loggerhead-instruments/iTag/spec_sheets/sensor_power_budget.xlsx

 | Manufacturer | Qty 1 price | Mode | mA | Notes
Accelerometer/Magnetometer/Gryoscope
LSM9DS1 | ST | $6.40 | 14.9 Hz | 1.9 | 64 byte FIFO gyroscope; 64 byte FIFO accelerometer
LSM9DS1 | ST |  | 59.5 Hz | 2.4 | no FIFO for magnetometer
LSM9DS1 | ST |  | 119 Hz | 3.1
LSM9DS1 | ST |  | 238-952 Hz (normal) | 4.3
LSM9DS1 |  |  | Accel + Mag (normal) | 0.6
MPU9250 | Invensense | $12.70 | 9-axis, 1 kHz gyro, 4 kHz accel, 8 Hz mag | 3.7 | 512 byte FIFO
MPU9250 |  |  | accelerometer 4 kHz, Mag 8 Hz | 0.73 | Can calculate and output quaternions
MPU9250 |  |  | accelerometer 31 Hz | 0.0198 | Can sample from up to 4 (24 bytes) I2C sensors into FIFO
MPU9250 |  |  | magnetometer 8 Hz | 0.28 | User programmable filters for sensors
 |  |  |  |  | Can read magnetometer directly for faster mag sample rate
Light Sensors
ISL29125 | Intersil | $3.19 | RGB | 0.056
Pressure Temperature
MS5803-30BA | Measurement Specialties | $27.91 |  | 0.001 | max of 300 m
Series 4Ld…9LD | Keller (http://www.kelleramerica.com/categories/oem-sensors-transducers-transmitters.html) | $175 |  |  | 1 cm diameter max of 2000 m
Series 1 TAB | Keller (http://www.kelleramerica.com/categories/oem-sensors-transducers-transmitters.html) |  |  |  | need to add conditioning electronics and way for sensor to be exposed to ambient pressure
Series 7 | Keller (http://www.kelleramerica.com/categories/oem-sensors-transducers-transmitters.html) |  |  |  | need to add conditioning electronics ; selaed; 200 bar max; 15 mm
Series 7 Ly | Keller (http://www.kelleramerica.com/categories/oem-sensors-transducers-transmitters.html) |  |  |  | Voltage output; packaged with conditioning circuitry
