loggerhead-instruments/iTag/manual/setting up Arduino to use with iTag.pptx

Setting up Arduino IDE to use with iTag for testing sensors

1. Install Arduino
2. Tools Menu: Board.
  1. Select Arduino/Genuino Zero (Native USB Port)
  2. If that is not a choice, go to top of list and open Boards Manager, and install Arduino SAMD Boards (32-bits ARM Cortex-M0+) by Arduino
3. iTag Board
  1. Plug in battery
  2. Plug in USB
  3. It should connect to USB
  4. From Arduino Tools menu, select Port and see if you see a COM port with the Arduino/Genuino Zero, and select it
4. Serial Monitor
  1. Open Serial monitor from Arduino Tools menu
  2. Type a 9 in the box at the top and press Enter to start the test sequence. Once the test sequence is over, you can remove the microSD card to open the CSV file. You can run multiple tests in a row by pressing 9. They will be appended to the same CSV.

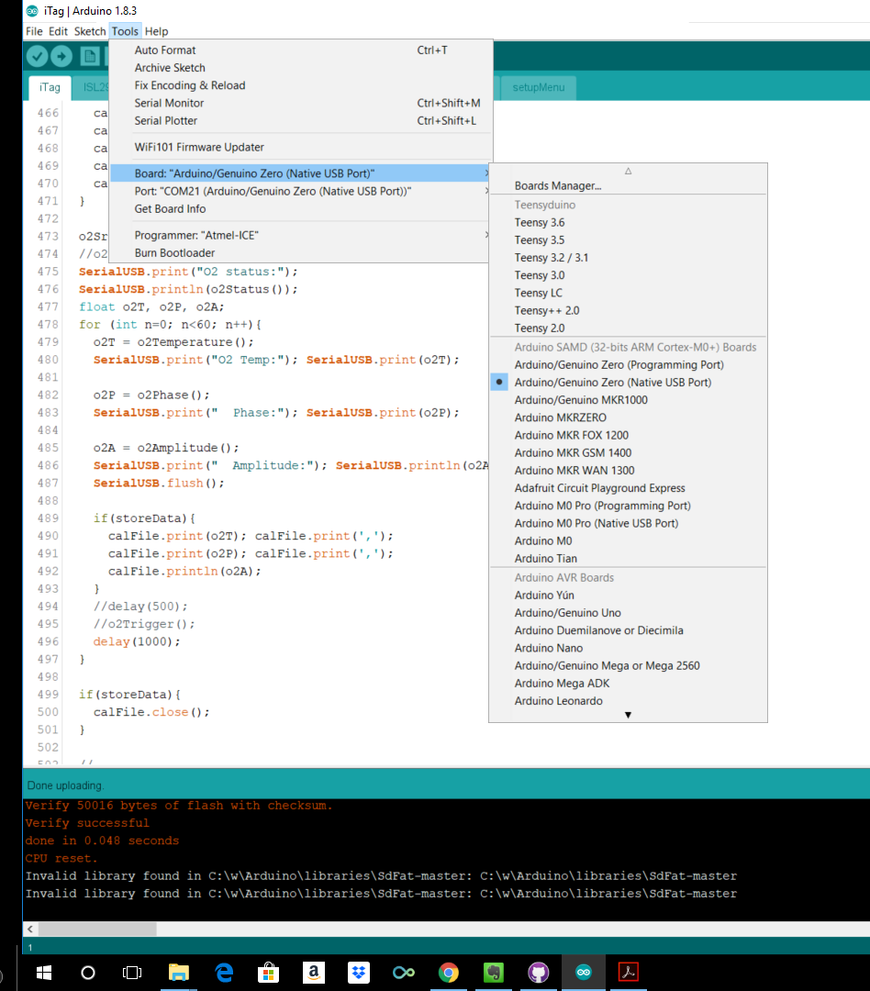
[picture p1: figure]
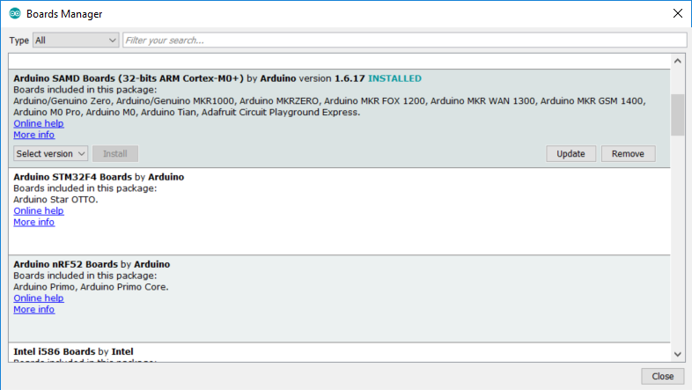
[picture p2: figure]

## Slide 2

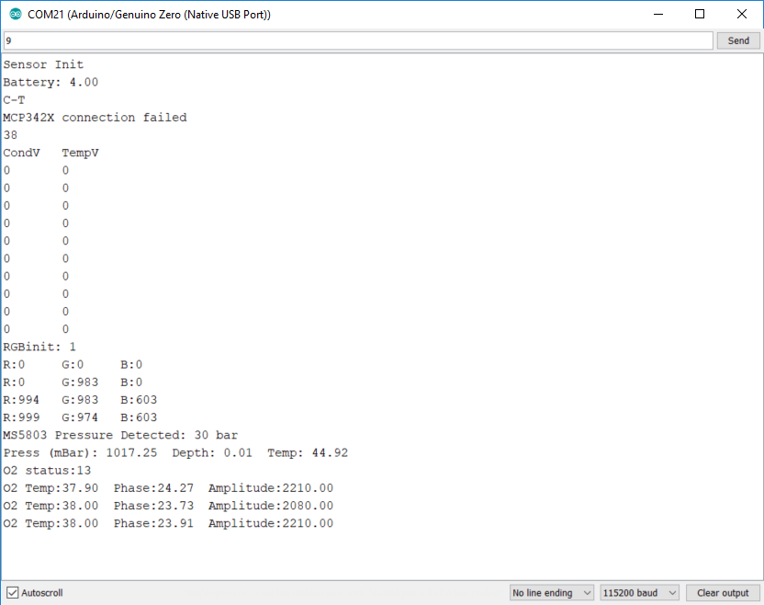
[picture p3: figure]
