loggerhead-instruments/iTag/manual/iTagLayout.png

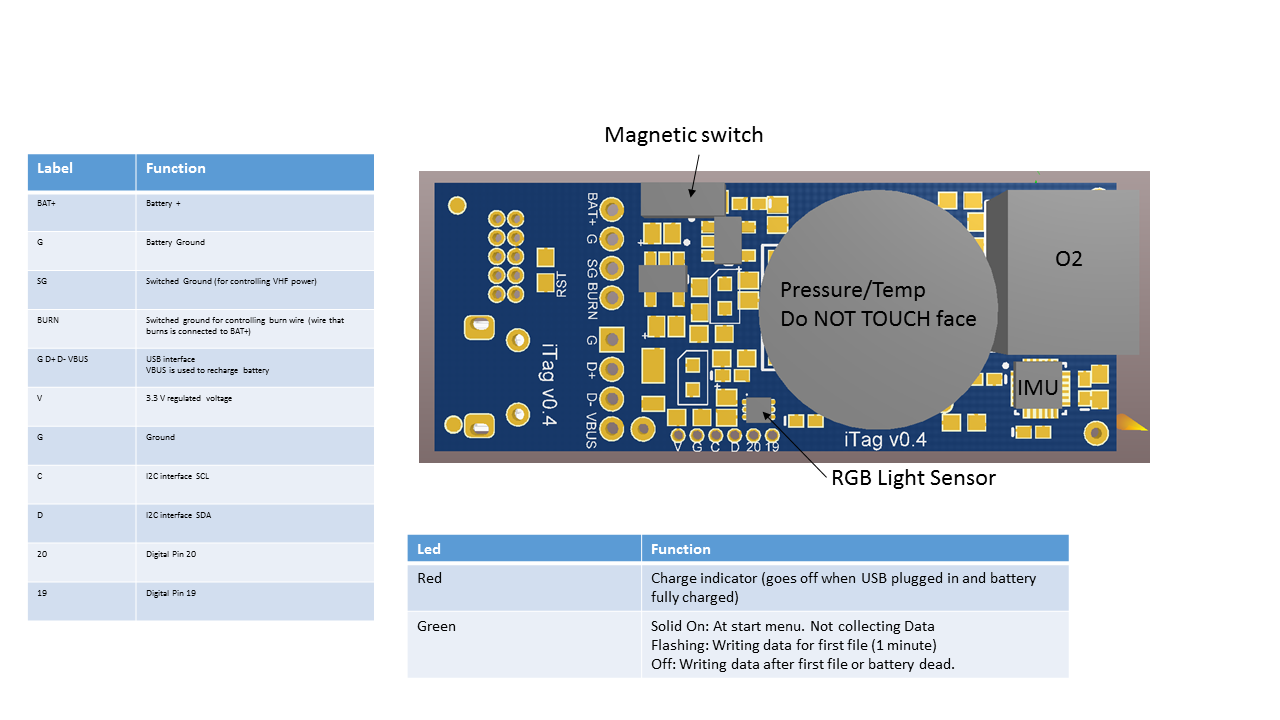
manual/iTagLayout.png
