loggerhead-instruments/iTag/Arduino/salinityTest/salinity_temp.PNG

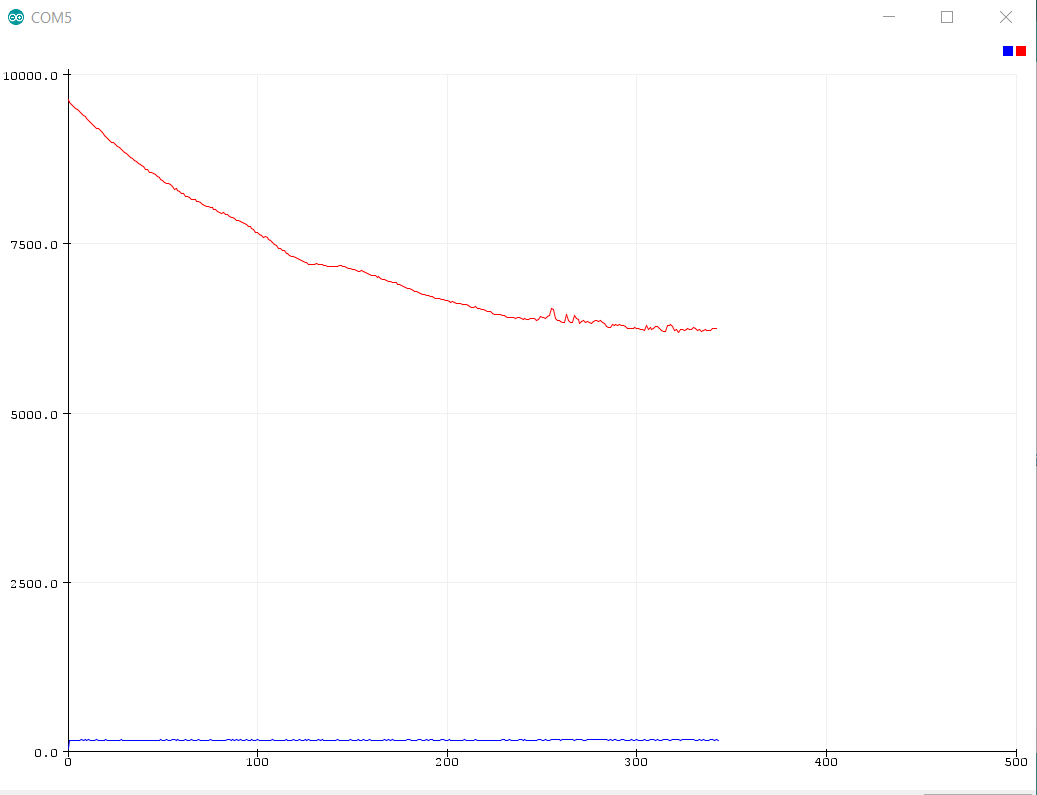
Arduino/salinityTest/salinity_temp.PNG
