loggerhead-instruments/iTag/Arduino/salinityTest/salnity.PNG

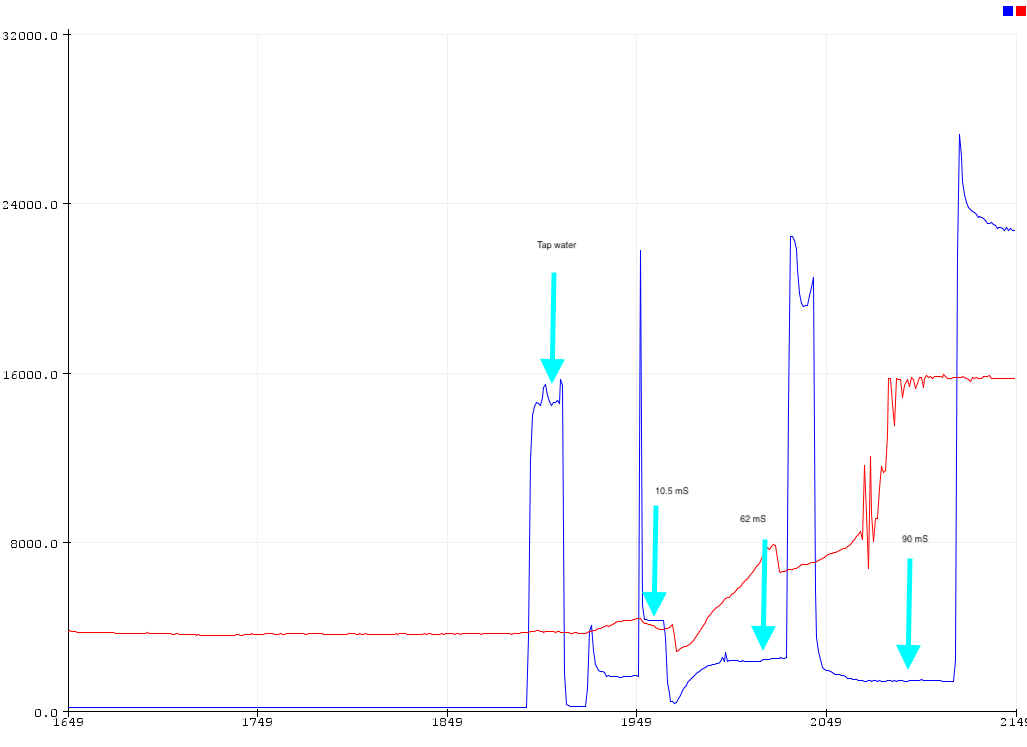
Arduino/salinityTest/salnity.PNG
