loggerhead-instruments/iTag/(threads)

Thread 1 (2017-02-02):

O2 phase dropouts

davidallenmann, 2017-02-02:
Occasional bad readings (0 value) of O2. Temperature and amplitude seem to read correctly.

Thread 2 (2017-02-02):

IMU wav file chunk size error in MATLAB

davidallenmann, 2017-02-02:
After conversion with AMXconvert
Other sensor wave files are readable in matlab with wavread.
Get Chunk Size error with IMU wav file.
Reading in wav file with wavLoad.m; the header seems correct in terms of number of data points and header.

IMU wav file recorded on AMX does not give error.

Thread 3 (2017-02-02):

I2C download of MPU is slow

davidallenmann, 2017-02-02:
60 ms to download buffer of 280 bytes

davidallenmann, 2017-05-03:
reading from interrupt and getting 20 bytes at a time

Closed 2017-05-03.

Thread 4 (2017-02-02):

O2 sensor fails to start sometimes

davidallenmann, 2017-02-02:
pulling of O2 and putting back on solves...need way to test and reset from software

davidallenmann, 2017-02-02:
in sensorInit() turn off power to O2 sensor and then back on

Closed 2017-02-02.

Thread 6 (2017-04-06):

dropped sample in IMU

davidallenmann, 2017-04-06:
- need to be able to identify when it happens
- is issue getting data off IMU in time (check overflow) or in writing to card fast enough?

davidallenmann, 2017-04-06:
may be related to #3

Closed 2017-05-03.
