loggerhead-instruments/iTag/spec_sheets/salinity/USF_ASCB_schematic.pdf

# IO Circuits

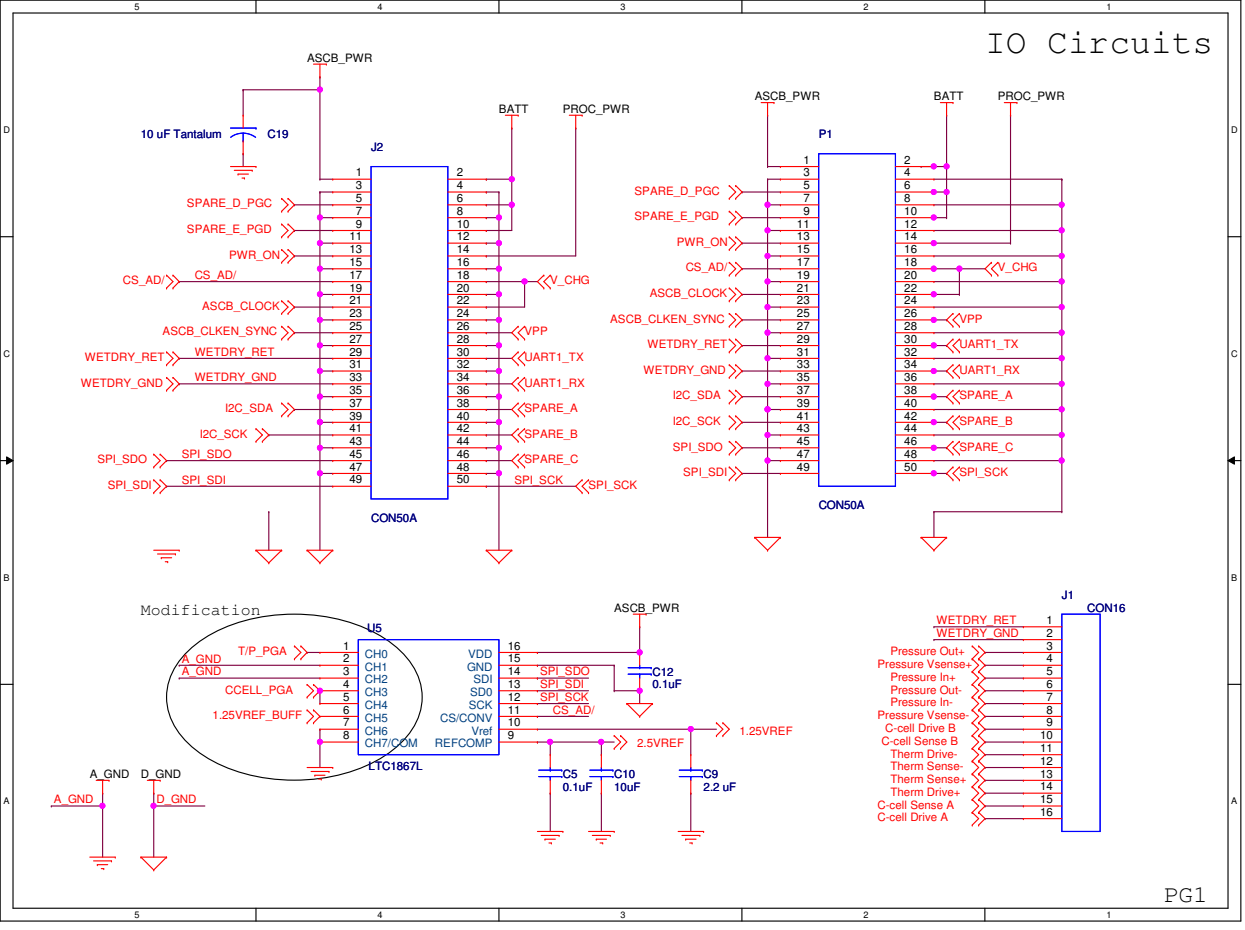
[picture p13: page 1]

# Ccell-Const Current

## LTC - Low Thermal Expansion Resistors

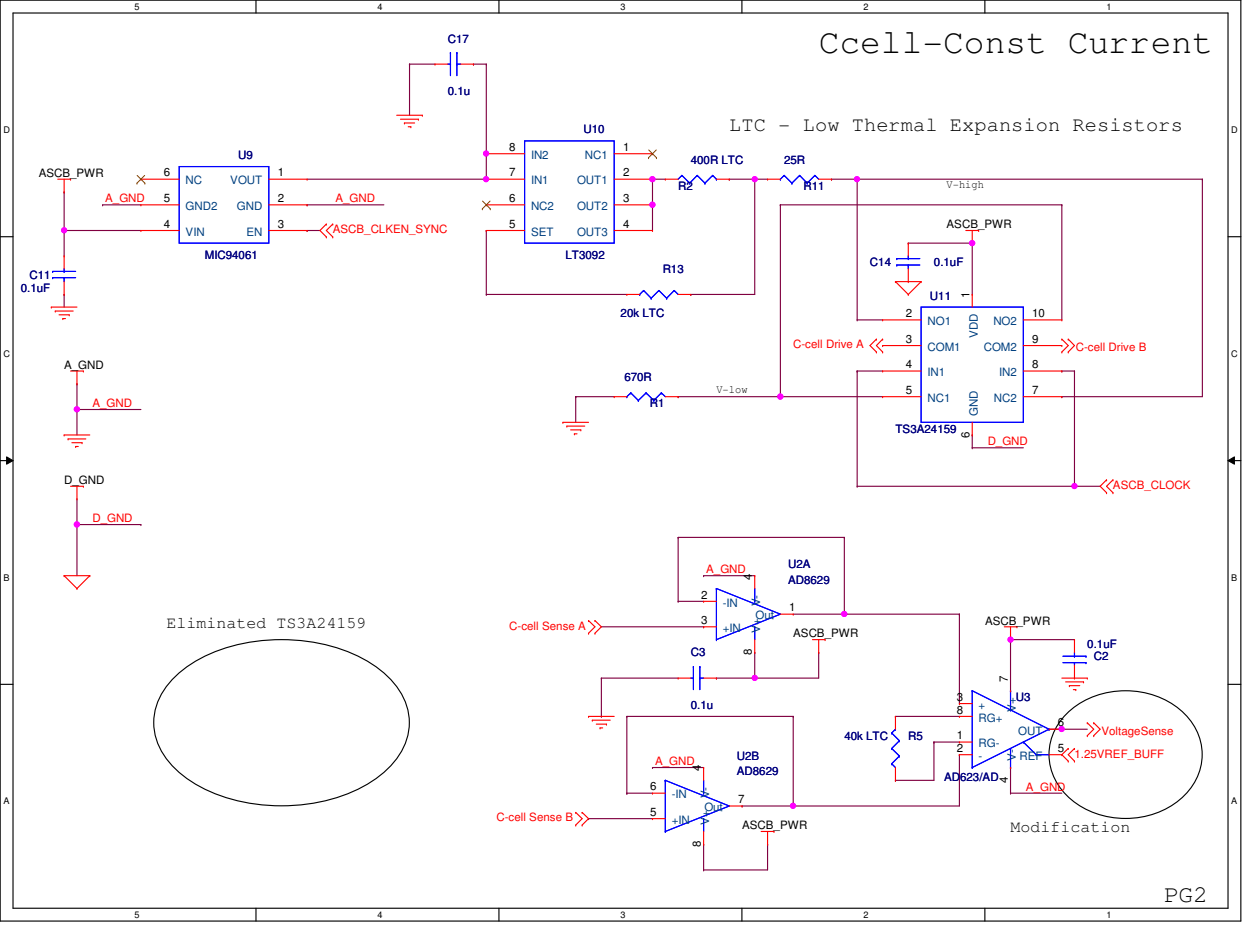
[picture p14: page 2]

# Temp Sensor

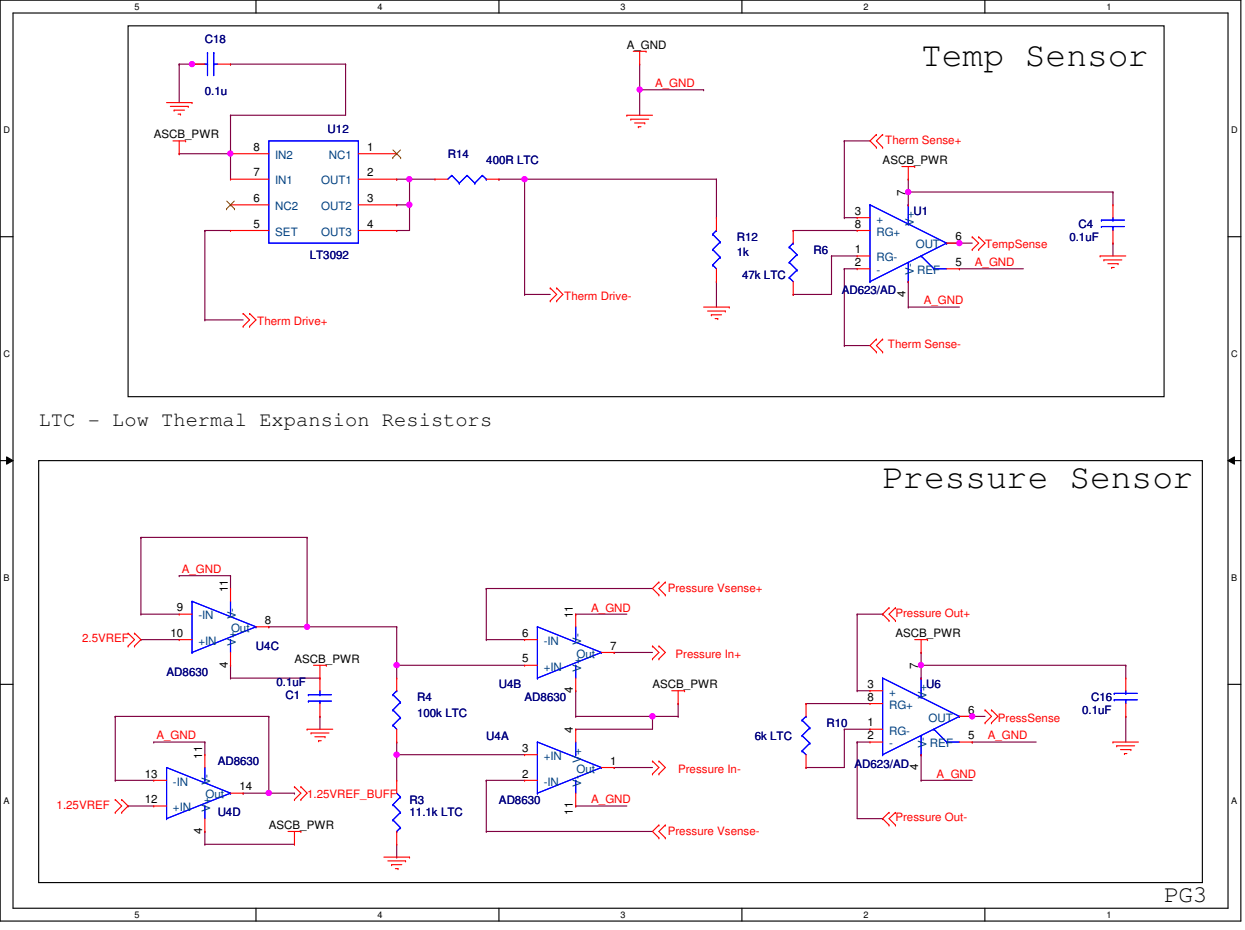
[picture p15: page 3]

LTC - Low Thermal Expansion Resistors

# PGA_ADC Driver

## LTC - Low Thermal Expansion Resistors

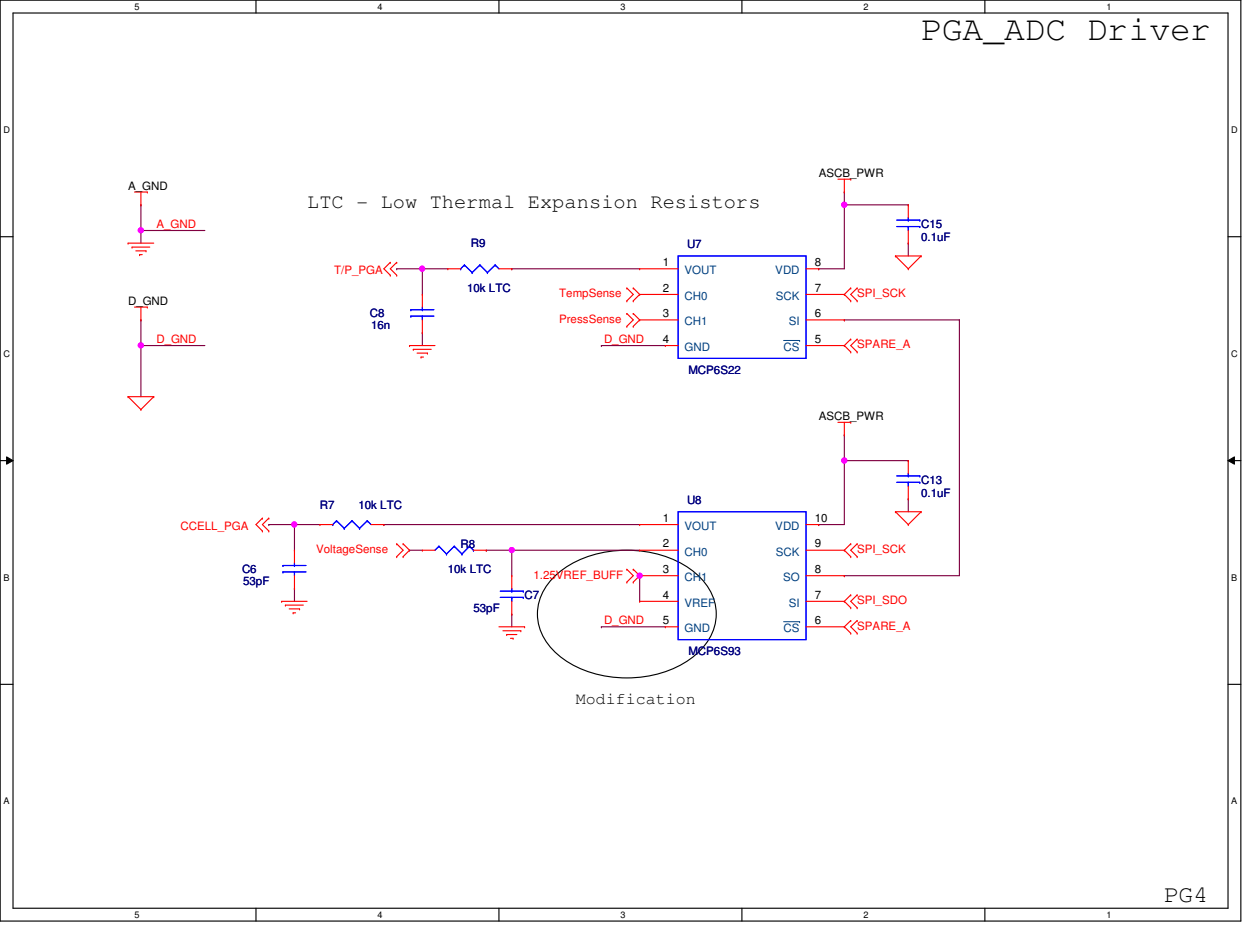
[picture p16: page 4]
