loggerhead-instruments/iTag/Altium/iTag3/iTag4.PDF

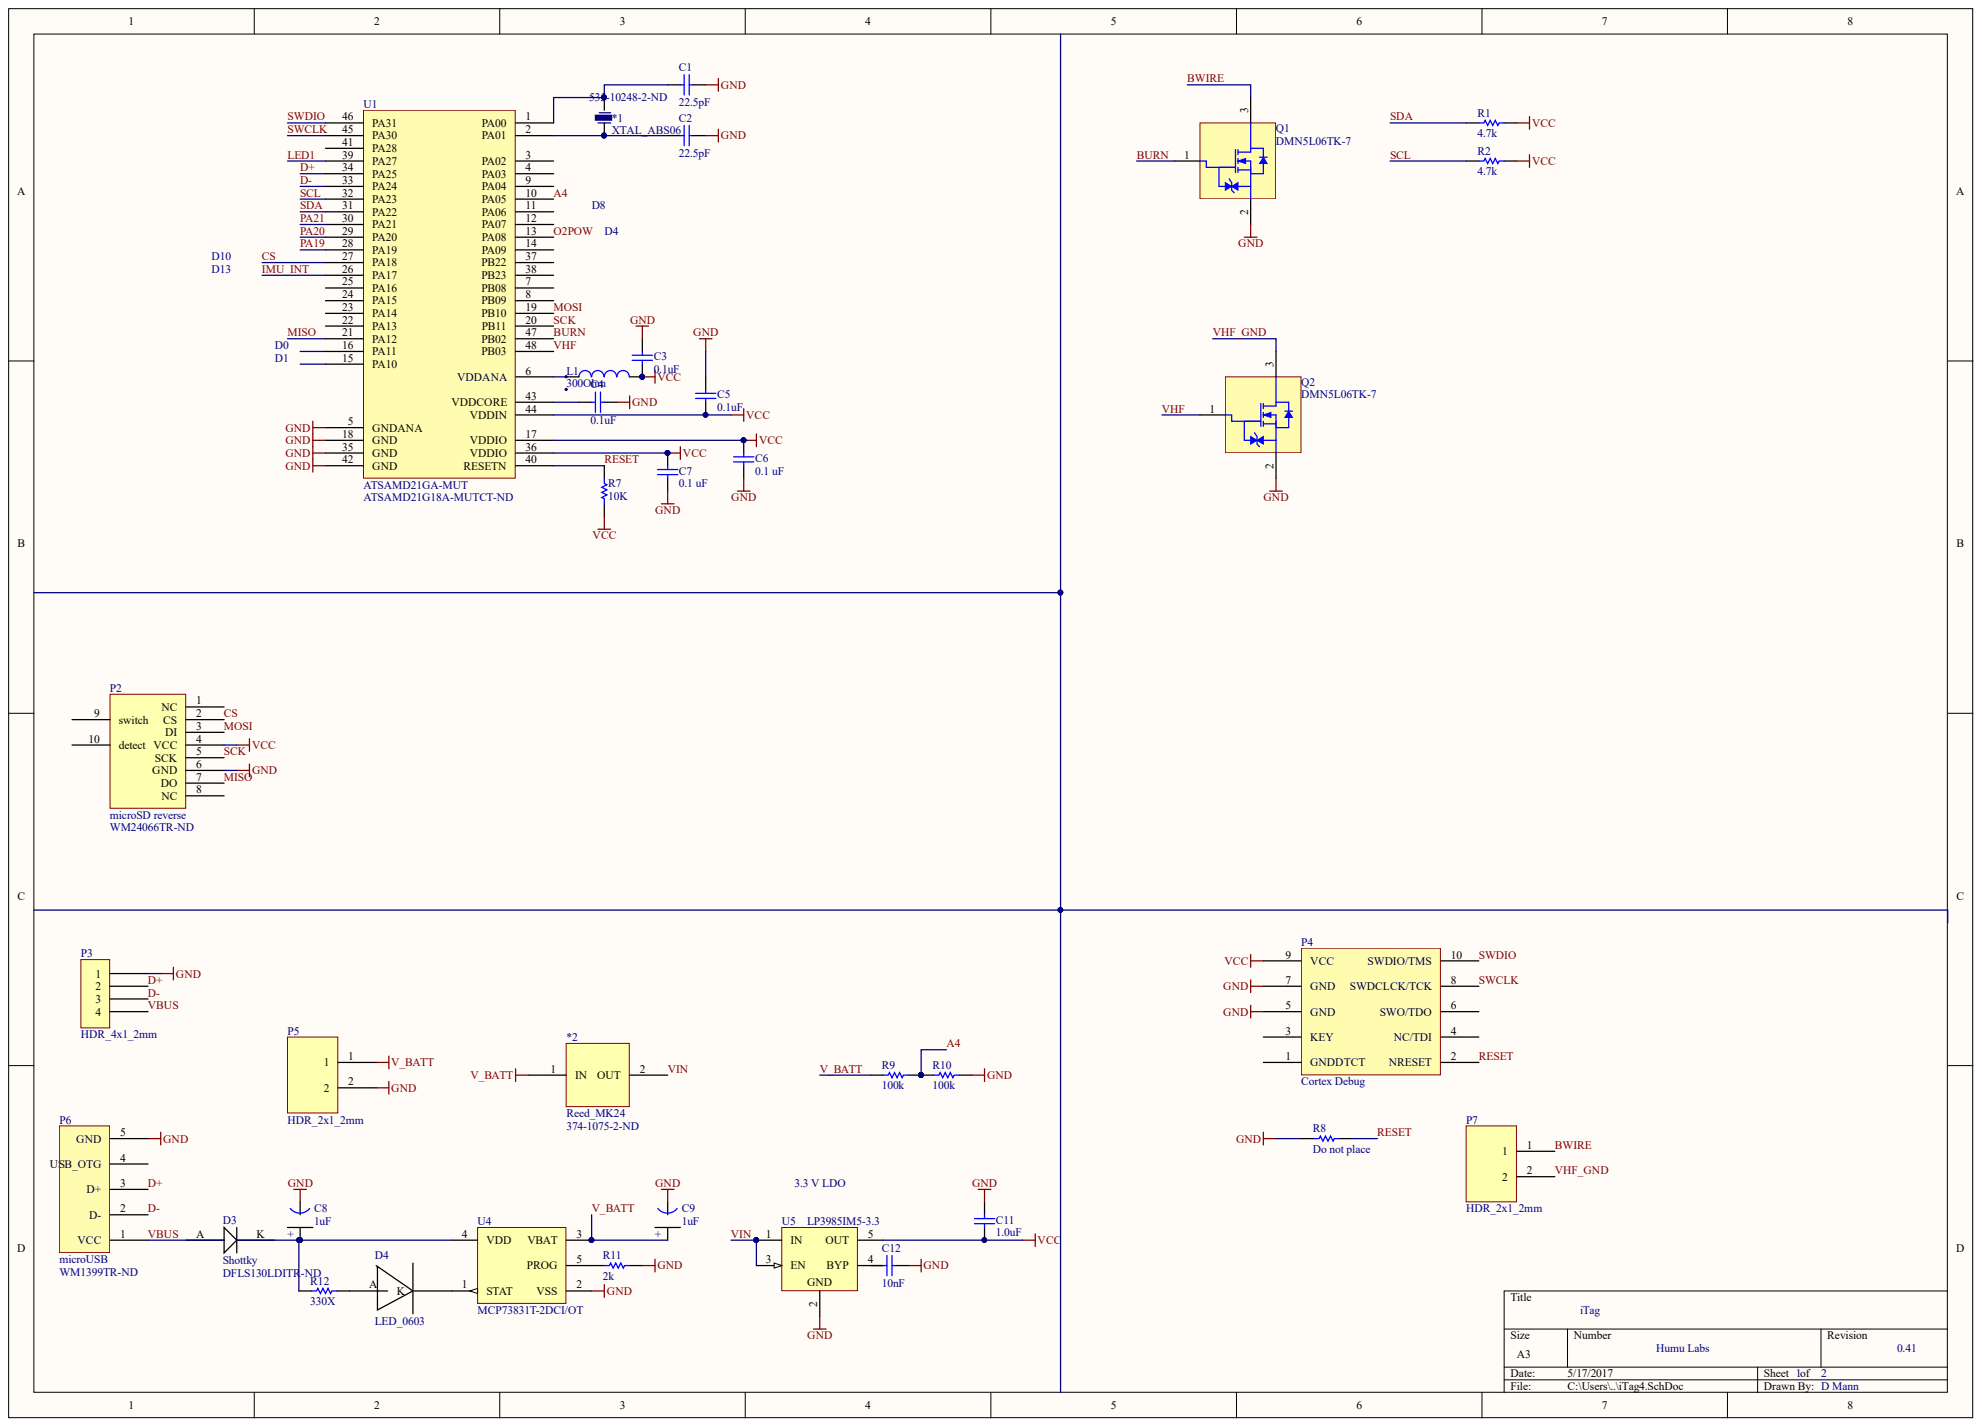
[picture p20: page 1]

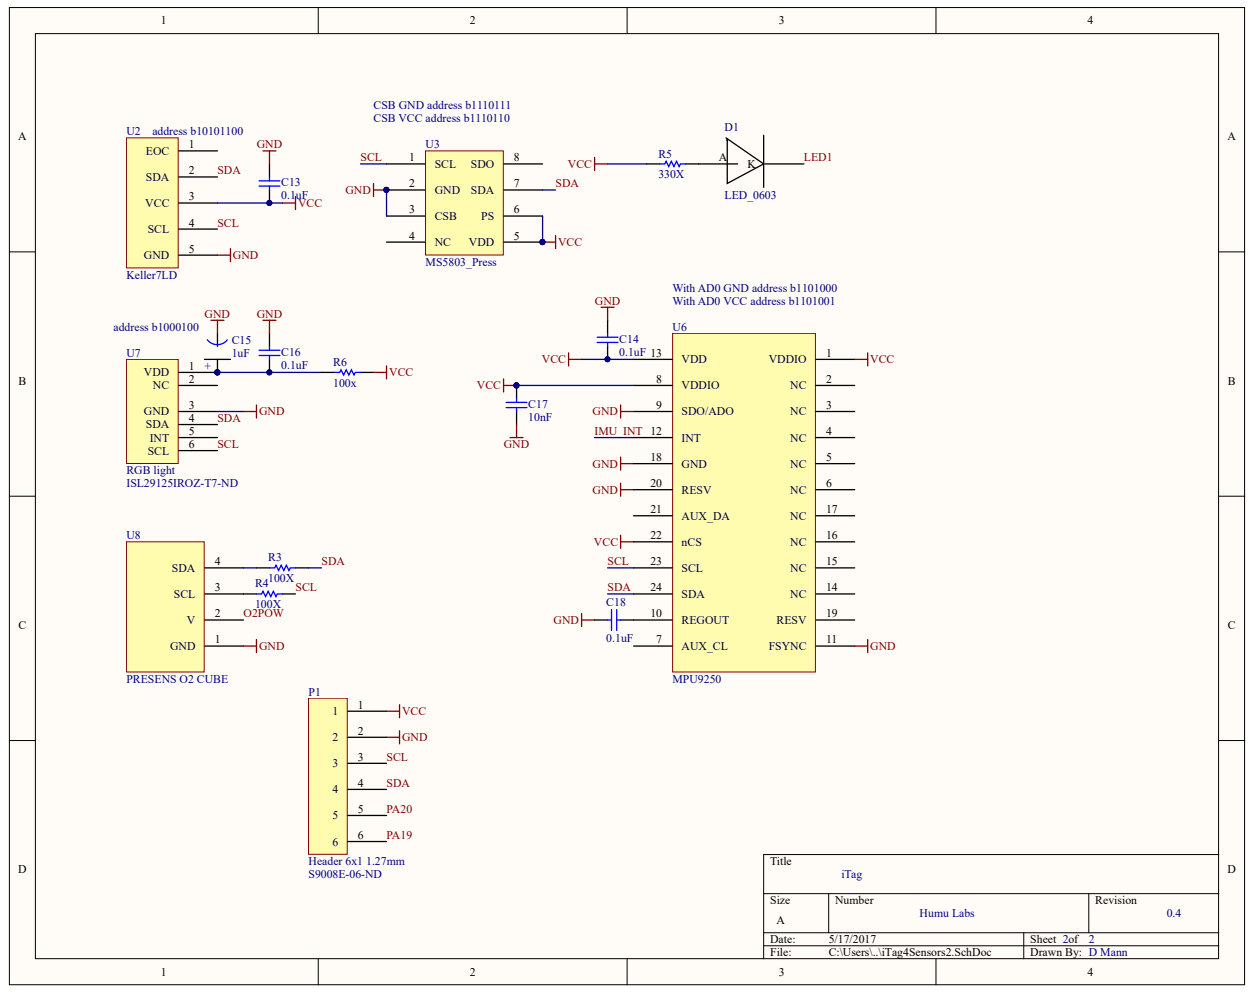
[picture p21: page 2]

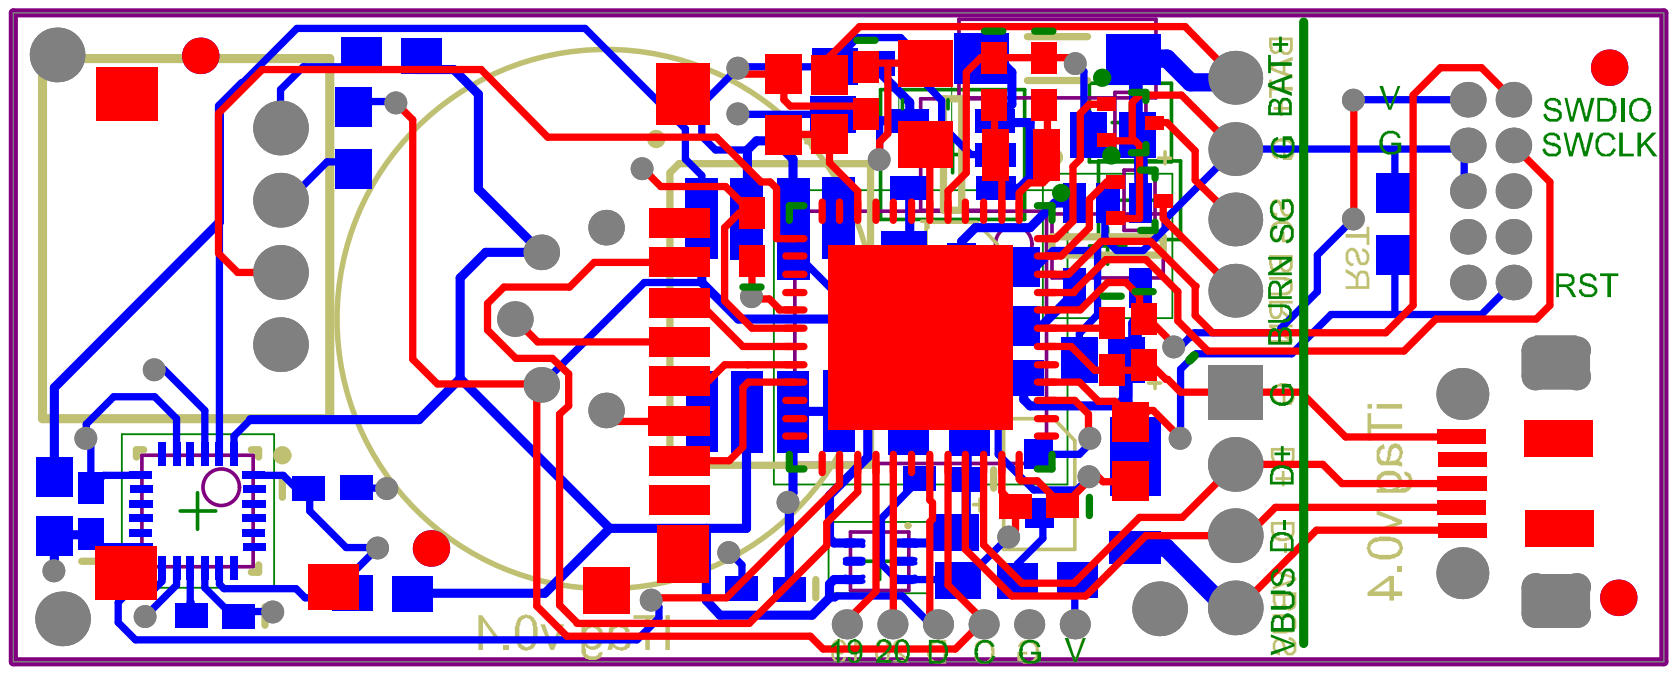
[picture p22: page 3]

Comment | Description | Designator | Footprint | LibRef | Quantity
XTAL_ABS06 | *1 | XTAL-ABS06 | XTAL_ABS06 | 1
Reed_MK24 | *2 | Reed MK24-B-3 | Reed_MK24 | 1
22.5pF | Ceramic Chip Capacitor -
0.1uF | Ceramic Chip Capacitor -Standard | C3, C4, C5, C13, C14, C16,
0.1 uF | Ceramic Chip Capacitor -
Standard | C1, C2 | 0402 | C0402 | 2
C18 | 0402 | C0402 | 7
Standard | C6, C7 | 0402 | C0402 | 2
1uF | C8, C9, C15 | Tant0805 | Tant0805 | 3
1.0uF | Ceramic Chip Capacitor -
10nF | Ceramic Chip Capacitor -
Standard | C11 | 0402 | C0402 | 1
Standard | C12, C17 | 0402 | C0402 | 2
LED_0603 | D1, D4 | Diode0603 | LED_0603 | 2
Shottky | D3 | DFLS130 | DFLS130 | 1

# 300Ohm

# Ferrite 25mOhm@DC, 60

Ohm@100MHz | L1 | 0805 (M2125) Ferrite | Ferrite 0805(M2125) 3A | 1
Header 6x1 1.27mm | P1 | Header6x1 1.27mm | Header 6x1 1.27mm | 1
microSD reverse | P2 | miroSD_reverse | microSD reverse | 1
HDR_4x1_2mm | P3 | Hdr_4x1_2mm | HDR_4x1_2mm | 1
Cortex Debug | P4 | Header_2x5_50mil | CortexDebug | 1
HDR_2x1_2mm | P5, P7 | HDR_2x1_2mm | HDR_2x1_2mm | 2
microUSB | P6 | microUSB-B | microUSB-B | 1
DMN5L06TK-7 | Ultra-low leakage
4.7k | Precision Thick Film Chip Resistor, 10 Ohm to 1M Ohm Range, 1% and 0.5% Tolerance, 0603 Size,
100X | Precision Thick Film Chip Resistor, 10 Ohm to 1M Ohm Range, 1% and 0.5% Tolerance, 0603 Size,
Enhanced MOSFET | Q1, Q2 | SOT-523 | FET DMN5L06TK-7 | 2
0.063 W | R1, R2 | 3-0603 | ERJ3RK | 2
0.063 W | R3, R4, R6 | 3-0603 | ERJ3RK | 3

# Precision Thick Film Chip

# Resistor, 10 Ohm to 1M

# Ohm Range, 1% and 0.5%

Tolerance, 0603 Size,
