loggerhead-instruments/iTag/Altium/salinity/salinity.PDF

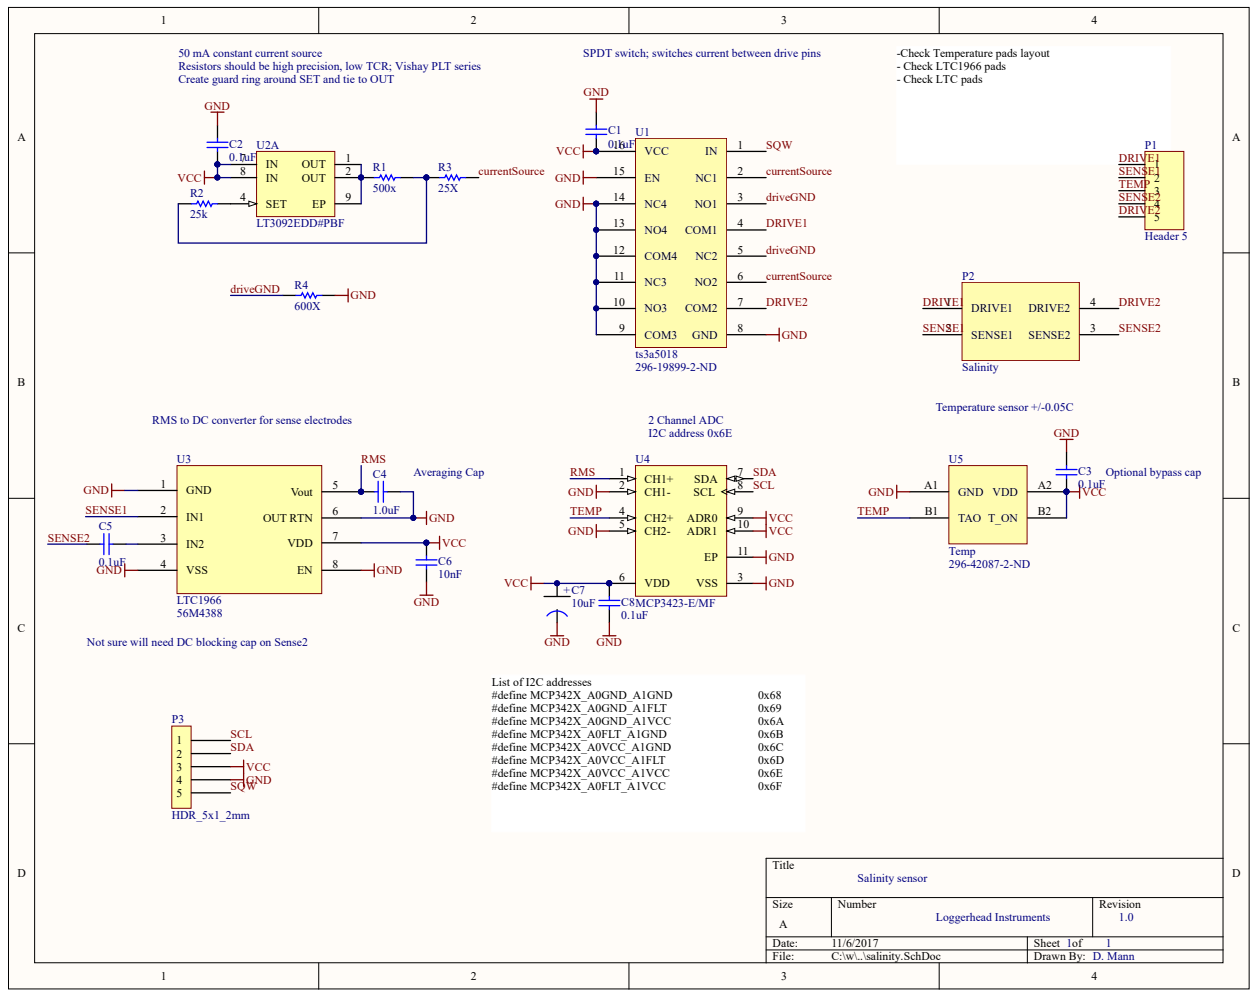
[picture p23: page 1]

Resistors should be high precision, low TCR; Vishay PLT series
Create guard ring around SET and tie to OUT

-Check Temperature pads layout
- Check LTC1966 pads
- Check LTC pads

Not sure will need DC blocking cap on Sense2

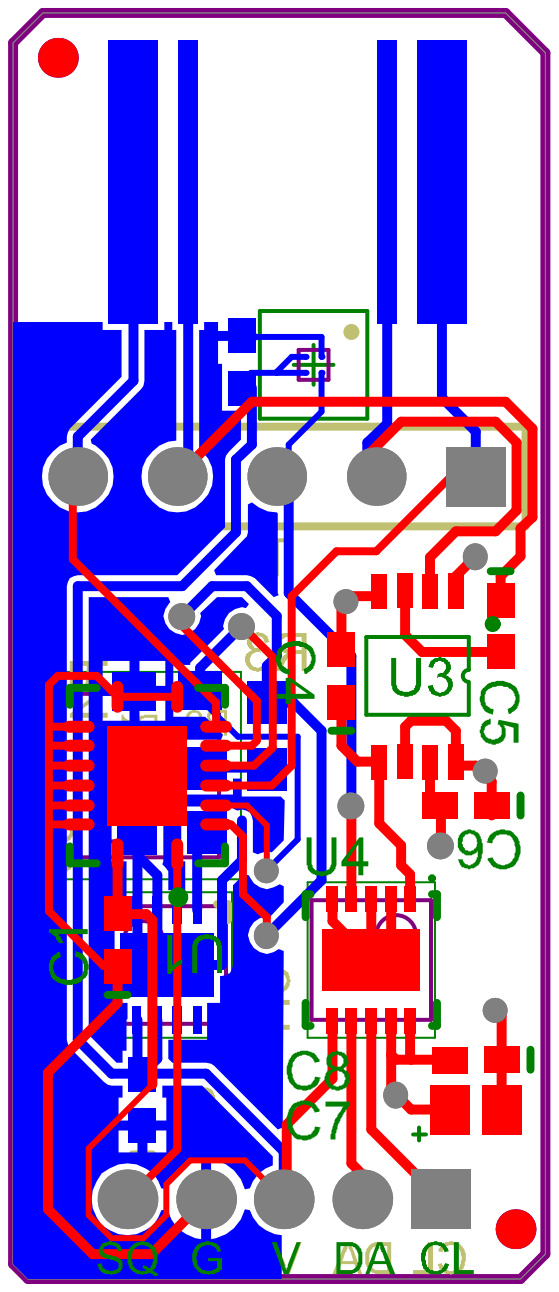
[picture p24: page 2]

# Board Stack
