loggerhead-instruments/iTag/spec_sheets/connectors/Molex_microSD_5027740891_sd.pdf

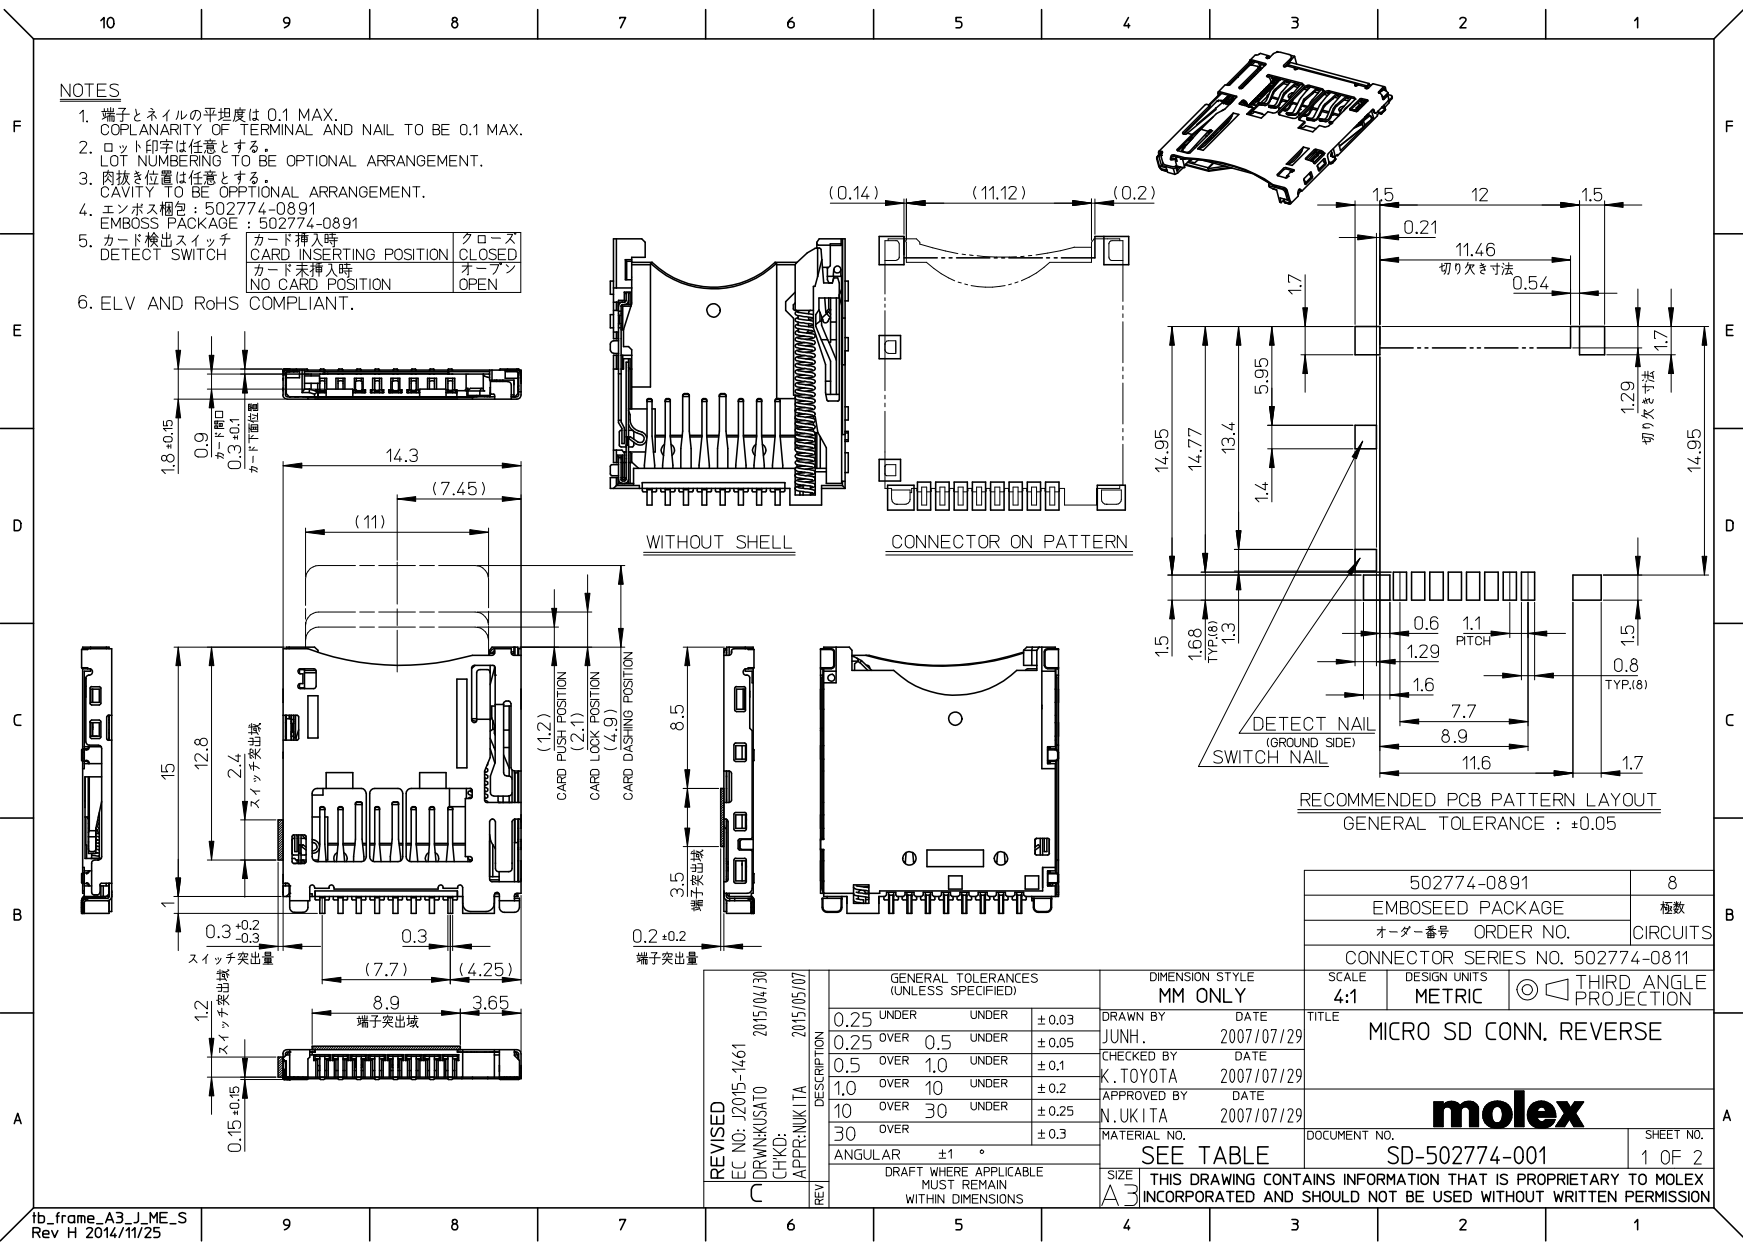
[picture p25: page 1]

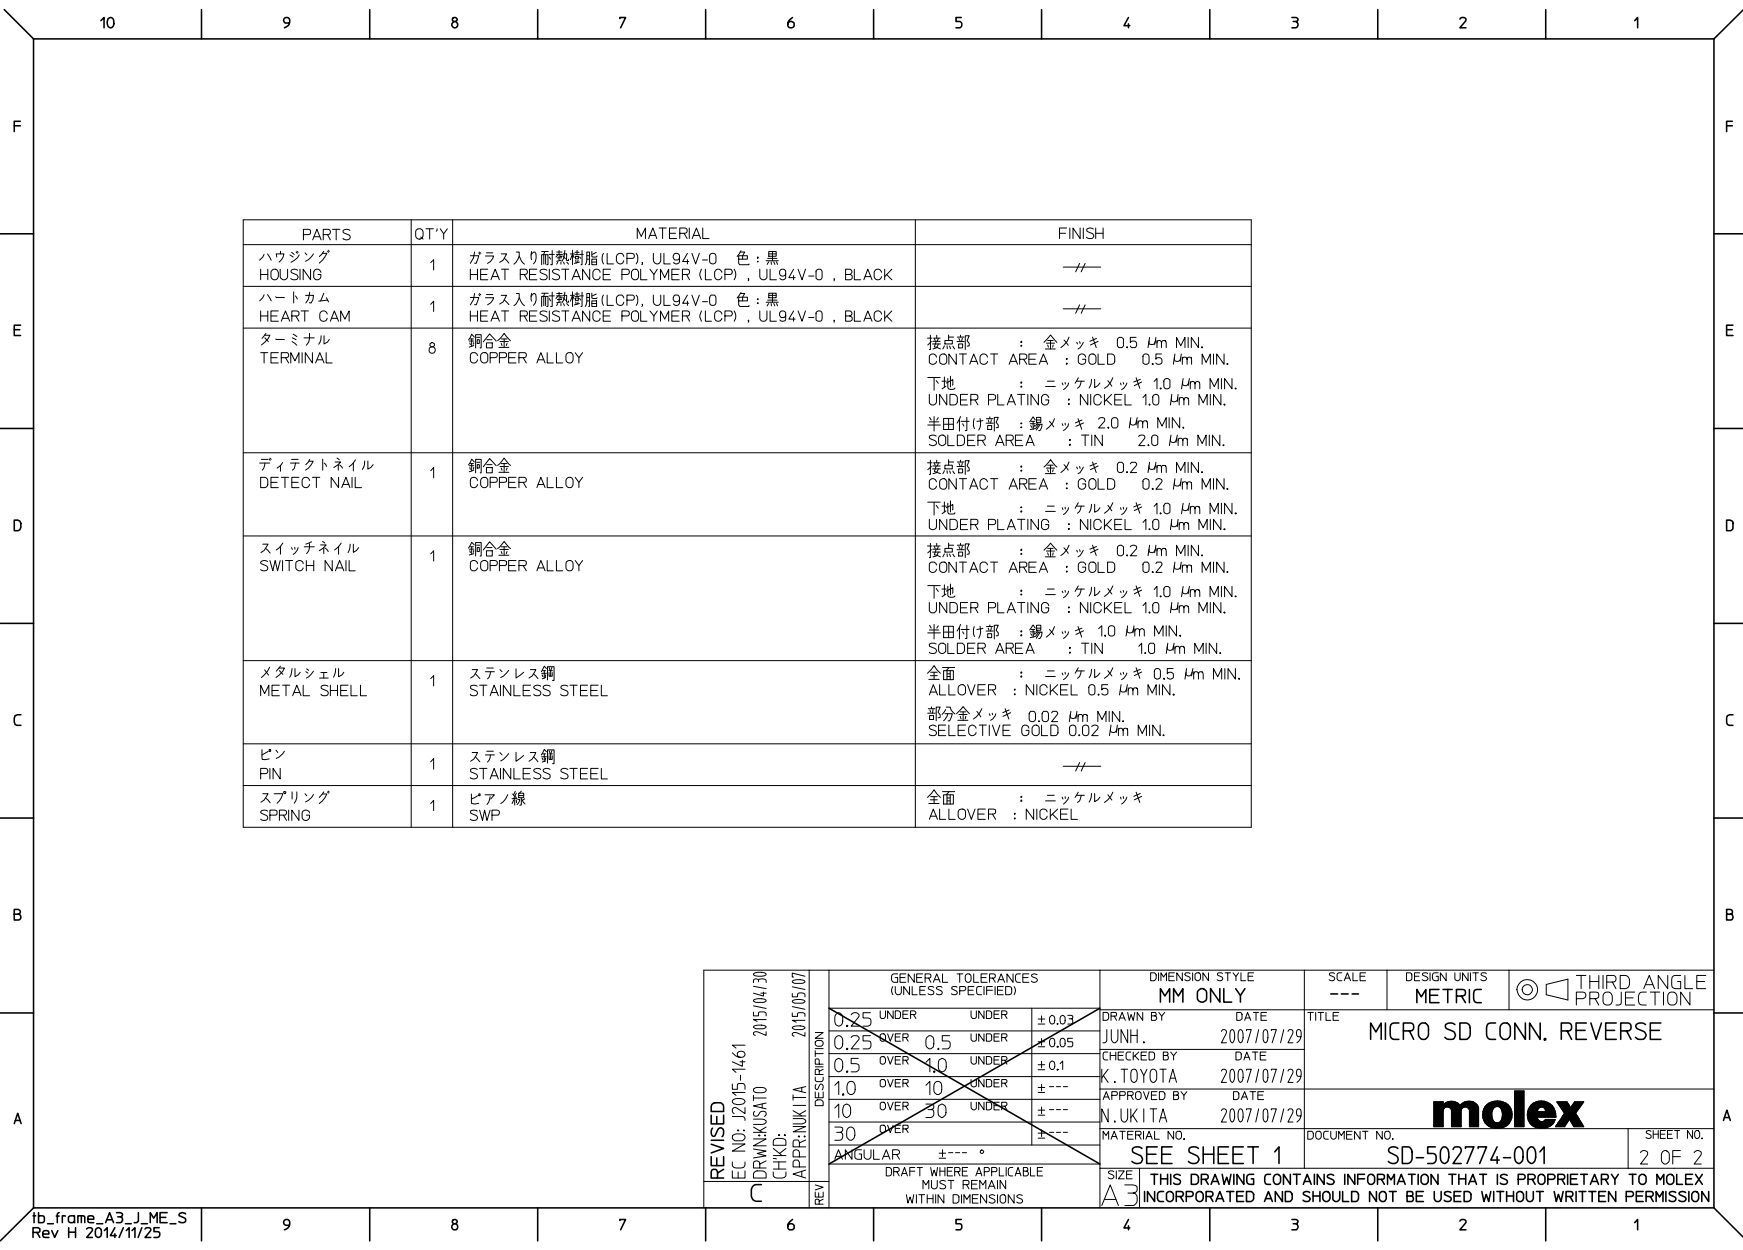
[picture p26: page 2]

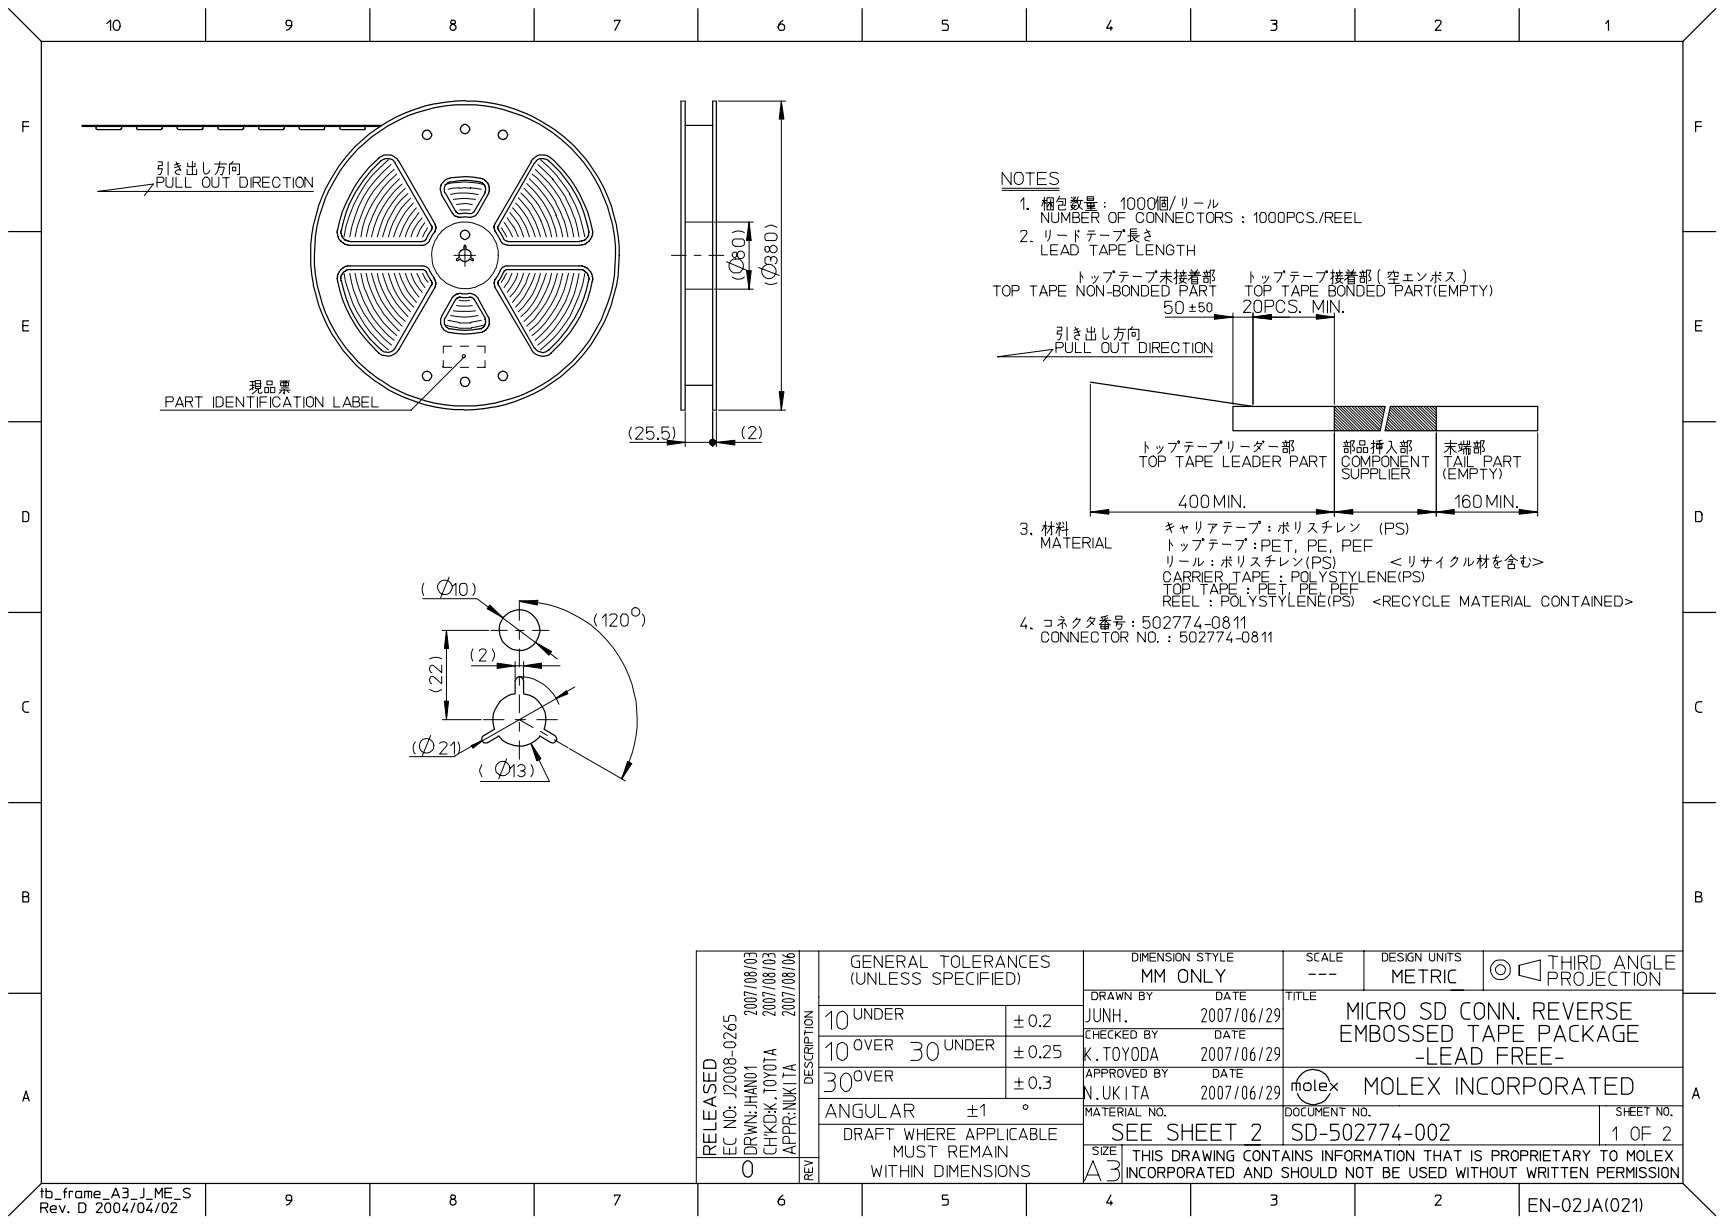
[picture p27: page 3]

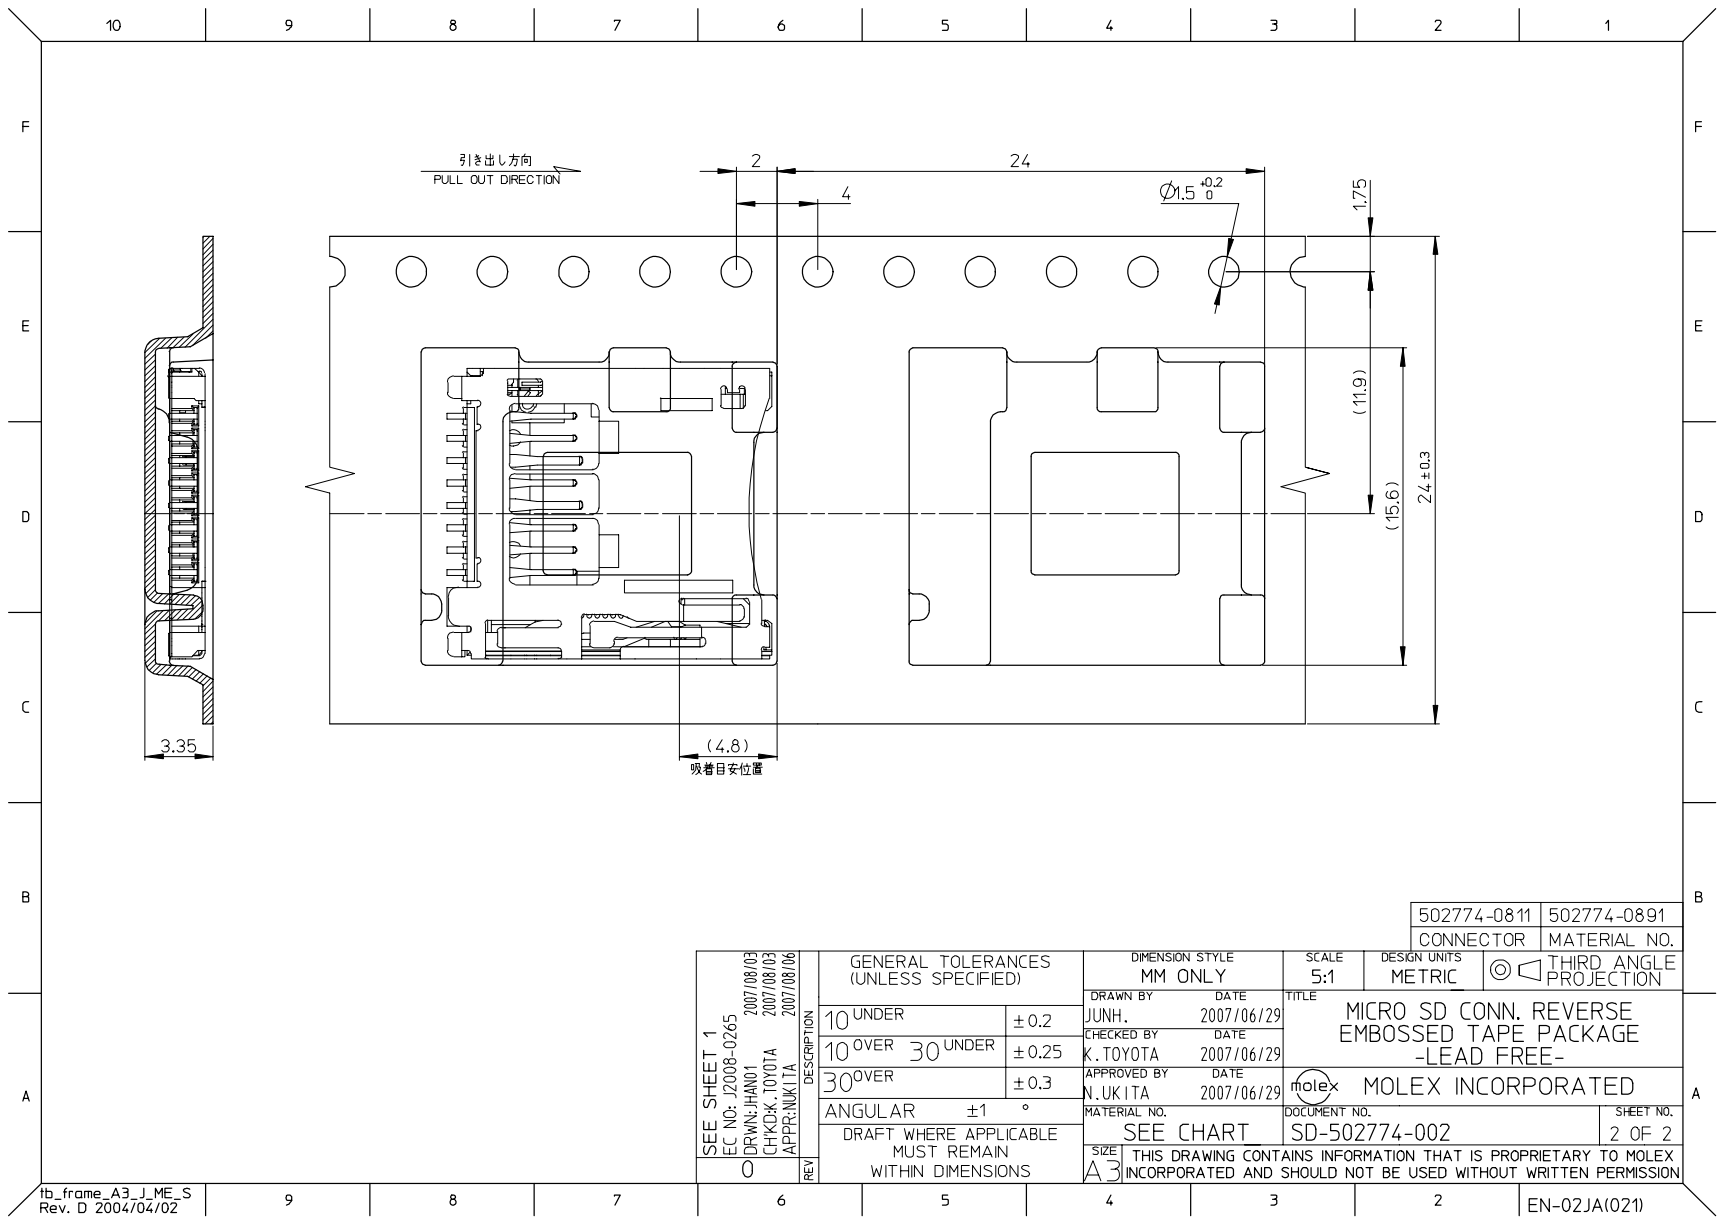
[picture p28: page 4]
