loggerhead-instruments/iTag/(list of files, drawings)

Other design files:
Altium/iTag3/iTag3.PcbDoc
Altium/iTag3/iTag3.PrjPCB
Altium/iTag3/iTag3.SchDoc
Altium/iTag3/iTag3_sensors.PcbDoc
Altium/iTag3/iTag3_sensors.SchDoc
Altium/iTag3/iTag3Sensors2.SchDoc
Altium/iTag3/iTag4.PcbDoc
Altium/iTag3/iTag4.PrjPCB
Altium/iTag3/iTag4.SchDoc
Altium/iTag3/iTag4Sensors2.SchDoc
Altium/iTag3/iTagSensors.PrjPCB
Altium/iTag3/Project Outputs for iTag4/iTag4.PcbDoc
Altium/iTag3/Project Outputs for iTag4/pcbway/W20819ASQ22/yg/iTag4.PcbDoc
Altium/salinity/salinity.PcbDoc
Altium/salinity/salinity.PrjPCB
Altium/salinity/salinity.SchDoc
