loggerhead-instruments/iTag/Arduino/iTagSensorTest/iTagSensorTest.ino

// iTag
// Board bootloader loaded using AtmelICE and Board: Arduino Zero Programming Port
// Board programmed using USB via Arduino Zero Native USB port


#include <Wire.h>
#include <SPI.h>
#include <SD.h>
#include <RTCZero.h>

// To Do:
// - O2 sensor
// - Setup timer interrupt with sleep to read IMU

int printDiags = 1;

const int ledGreen = PIN_LED_TXL;
const int BURN = A5;
const int vSense = A4; 
const int VHF = PIN_LED_RXL;
const int O2POW = 4;
const int chipSelect = 10;
const int mpuInterrupt = 13;

int pressure_sensor;

volatile int state = LOW;

// IMU
int FIFOpts;
#define BUFFERSIZE 280 // used this length because it is divisible by 20 bytes (e.g. A*3,M*3,G*3,T) and 14 (w/out mag)
byte imuBuffer[BUFFERSIZE]; // buffer used to store IMU sensor data before writes in bytes
int16_t accel_x;
int16_t accel_y;
int16_t accel_z;
int16_t magnetom_x;
int16_t magnetom_y;
int16_t magnetom_z;
int16_t gyro_x;
int16_t gyro_y;
int16_t gyro_z;
float gyro_temp;

// RGB
int16_t islRed;
int16_t islBlue;
int16_t islGreen;

// Pressure/Temp
byte Tbuff[3];
byte Pbuff[3];
volatile float depth, temperature;
boolean togglePress; //flag to toggle conversion of pressure and temperature

//Pressure and temp calibration coefficients
uint16_t PSENS; //pressure sensitivity
uint16_t POFF;  //Pressure offset
uint16_t TCSENS; //Temp coefficient of pressure sensitivity
uint16_t TCOFF; //Temp coefficient of pressure offset
uint16_t TREF;  //Ref temperature
uint16_t TEMPSENS; //Temperature sensitivity coefficient

// Pressure, Temp double buffer
#define PTBUFFERSIZE 40
float PTbuffer[PTBUFFERSIZE];
byte time2writePT = 0; 
int ptCounter = 0;
volatile byte bufferposPT=0;
byte halfbufPT = PTBUFFERSIZE/2;
boolean firstwrittenPT;

// RGB buffer
#define RGBBUFFERSIZE 120
byte RGBbuffer[RGBBUFFERSIZE];
byte time2writeRGB=0; 
int RGBCounter = 0;
volatile byte bufferposRGB=0;
byte halfbufRGB = RGBBUFFERSIZE/2;
boolean firstwrittenRGB;

File dataFile;

/* Create an rtc object */
RTCZero rtc;

volatile unsigned int irq_ovf_count = 0; // keep track of IMU polling

/* Change these values to set the current initial time */
const byte seconds = 0;
const byte minutes = 00;
const byte hours = 17;

/* Change these values to set the current initial date */
const byte day = 17;
const byte month = 11;
const byte year = 15;


void setup() {
  SerialUSB.begin(57600);
  
  delay(10000);
  Wire.begin();
 // Wire.setClock(100);  // set I2C clock to 100 kHz
  SerialUSB.println("iTag sensor test");

  // see if the card is present and can be initialized:
  if (!SD.begin(chipSelect)) {
    SerialUSB.println("Card failed, or not present");
    // don't do anything more:
    return;
  }
  SerialUSB.println("Card initialized"); 
}

void loop() {
    sensorInit();
    SerialUSB.println("Test Complete");
    SerialUSB.println("Restarting in 1s");
    mpuInit(1);
    for (int i = 0 ; i<100; i++){
      pollImu();
      delay(100);
    }
    delay(1000);
}

void sensorInit(){
 // initialize and test sensors
  String dataString = "";
  dataFile = SD.open("log.txt", FILE_WRITE);
  SerialUSB.println("Sensor Init");

  SerialUSB.println("Setting up outputs...");
  //pinMode(ledGreen, OUTPUT);
  SerialUSB.println("ledGreen output");
  //REG_PORT_DIRSET0 = PORT_PA27;
  pinMode(BURN, OUTPUT);
  pinMode(VHF, OUTPUT);
  pinMode(vSense, INPUT);
  pinMode(O2POW, OUTPUT);


  // Digital IO
  
  SerialUSB.println("Turning green LED on");
 // digitalWrite(ledGreen, HIGH);
  //REG_PORT_OUTSET0 = PORT_PA27;
  digitalWrite(BURN, HIGH);
  digitalWrite(VHF, HIGH);
  digitalWrite(O2POW, HIGH);

  SerialUSB.println("Green LED on");

  // RGB
  islInit(); 
  for(int n=0; n<2; n++){
      islRead();
      SerialUSB.print("R:"); SerialUSB.print(islRed); SerialUSB.print("\t");
      SerialUSB.print("G:"); SerialUSB.print(islGreen); SerialUSB.print("\t");
      SerialUSB.print("B:"); SerialUSB.println(islBlue);
      delay(500);
  }
  
 // digitalWrite(ledGreen, LOW);
  //REG_PORT_OUTCLR0 = PORT_PA27;
  digitalWrite(BURN, LOW);
  digitalWrite(VHF, LOW);


  SerialUSB.println("Green LED off");

// battery voltage measurement
  SerialUSB.print("Battery: ");
  SerialUSB.println(analogRead(vSense));

  
// Pressure--auto identify which if any is present
  pressure_sensor = 0;
  // Keller
  if(kellerInit()) {
    pressure_sensor = 2;   // 2 if present
    SerialUSB.println("Keller Pressure Detected");
    kellerConvert();
    delay(10);
    kellerRead();
    SerialUSB.print("Depth: "); SerialUSB.println(depth);
    SerialUSB.print("Temperature: "); SerialUSB.println(temperature);
  }
  

  // Measurement Specialties
  if(pressInit()){
    pressure_sensor = 1;
    SerialUSB.println("MS Pressure Detected");
    updatePress();
    delay(10);
    readPress();
    updateTemp();
    delay(10);
    readTemp();
    calcPressTemp();
    SerialUSB.print("Depth: "); SerialUSB.println(depth);
    SerialUSB.print("Temperature: "); SerialUSB.println(temperature);
  }

  // Presens O2
  SerialUSB.print("O2 status:");
  SerialUSB.println(o2Status());
  SerialUSB.print("Temperature:"); SerialUSB.println(o2Temperature());
  SerialUSB.print("Phase:"); SerialUSB.println(o2Phase());
  SerialUSB.print("Amplitude:"); SerialUSB.println(o2Amplitude());


  rtc.begin();
  rtc.setTime(hours, minutes, seconds);
  rtc.setDate(day, month, year);
  //rtc.attachInterrupt(alarmMatch);
 // rtc.enableAlarm(rtc.MATCH_SS);

  // IMU with sleep
 // mpuInit(1);
 // startTimer();
 // while(irq_ovf_count < 20);
 // stopTimer();
 // mpuInit(0); //gyro to sleep
/*
  dataString += String(islRed);
  dataString += ",";
  dataString += String(islGreen);
  dataString += ",";
  dataString += String(islBlue);
  dataFile.println(dataString);
  dataFile.close();
  */
}

boolean pollImu(){
  FIFOpts=getImuFifo();
  //SerialUSB.print("IMU FIFO pts: ");
  //SerialUSB.println(FIFOpts);
  if(FIFOpts>BUFFERSIZE)  //once have enough data for a block, download and write to disk
  {
     Read_Gyro(BUFFERSIZE);  //download block from FIFO
 
    if (printDiags){
    // print out first line of block
    // MSB byte first, then LSB, X,Y,Z
    accel_x = (int16_t) ((int16_t)imuBuffer[0] << 8 | imuBuffer[1]);    
    accel_y = (int16_t) ((int16_t)imuBuffer[2] << 8 | imuBuffer[3]);   
    accel_z = (int16_t) ((int16_t)imuBuffer[4] << 8 | imuBuffer[5]);    
    
    gyro_temp = (int16_t) (((int16_t)imuBuffer[6]) << 8 | imuBuffer[7]);   
   
    gyro_x = (int16_t)  (((int16_t)imuBuffer[8] << 8) | imuBuffer[9]);   
    gyro_y = (int16_t)  (((int16_t)imuBuffer[10] << 8) | imuBuffer[11]); 
    gyro_z = (int16_t)  (((int16_t)imuBuffer[12] << 8) | imuBuffer[13]);   
    
    magnetom_x = (int16_t)  (((int16_t)imuBuffer[14] << 8) | imuBuffer[15]);   
    magnetom_y = (int16_t)  (((int16_t)imuBuffer[16] << 8) | imuBuffer[17]);   
    magnetom_z = (int16_t)  (((int16_t)imuBuffer[18] << 8) | imuBuffer[19]);  

// Calculate pitch, roll, yaw
float radPerDeg = 0.0174532925;

// roll
float phi = atan2(accel_y, accel_z);
float sinAngle = sin(phi);
float cosAngle = cos(phi);

// de-rotate by roll angle
float Bfy = (magnetom_y * cosAngle) - (magnetom_z * sinAngle);
float Bz = (magnetom_y * sinAngle) + (magnetom_z * cosAngle);
float Gz = accel_y * sinAngle + accel_z * cosAngle;

// theta = pitch angle (-90 to 90 degrees)
float theta = atan(-accel_x / Gz);
sinAngle = sin(theta);
cosAngle = cos(theta);

// de-rotate by pitch angle theta
float Bfx = (magnetom_x * cosAngle) + (Bz * sinAngle);
float Bfz = (-magnetom_x * sinAngle) + (Bz * cosAngle);

// Psi = yaw = heading
float psi = atan2(-Bfy, Bfx);
float pitch = theta / radPerDeg;
float roll = phi / radPerDeg;
float yaw = 180 + (psi / radPerDeg);

    SerialUSB.print("a/g/m/t:\t");
    SerialUSB.print( accel_x); SerialUSB.print("\t");
    SerialUSB.print( accel_y); SerialUSB.print("\t");
    SerialUSB.print( accel_z); SerialUSB.print("\t");
    SerialUSB.print(gyro_x); SerialUSB.print("\t");
    SerialUSB.print(gyro_y); SerialUSB.print("\t");
    SerialUSB.print(gyro_z); SerialUSB.print("\t");
    SerialUSB.print(magnetom_x); SerialUSB.print("\t");
    SerialUSB.print(magnetom_y); SerialUSB.print("\t");
    SerialUSB.print(magnetom_z); SerialUSB.print("\t");
    SerialUSB.println((float) gyro_temp/337.87+21);
    SerialUSB.print("PRY: ");
    SerialUSB.print(pitch); SerialUSB.print("\t");
    SerialUSB.print(roll); SerialUSB.print("\t");
    SerialUSB.println(yaw); 
    }
    
    return true;
  }
  return false;
}

void startTimer(){
  
  // Enable clock for TC 
  REG_GCLK_CLKCTRL = (uint16_t) (GCLK_CLKCTRL_CLKEN | GCLK_CLKCTRL_GEN_GCLK0 | GCLK_CLKCTRL_ID ( GCM_TCC2_TC3 ) ) ;
  while ( GCLK->STATUS.bit.SYNCBUSY == 1 ); // wait for sync 

  // The type cast must fit with the selected timer mode 
  TcCount16* TC = (TcCount16*) TC3; // get timer struct

  TC->CTRLA.reg &= ~TC_CTRLA_ENABLE;   // Disable TCx
  while (TC->STATUS.bit.SYNCBUSY == 1); // wait for sync 

  TC->CTRLA.reg |= TC_CTRLA_MODE_COUNT16;  // Set Timer counter Mode to 16 bits
  while (TC->STATUS.bit.SYNCBUSY == 1); // wait for sync 
  TC->CTRLA.reg |= TC_CTRLA_WAVEGEN_NFRQ; // Set TC as normal Normal Frq
  while (TC->STATUS.bit.SYNCBUSY == 1); // wait for sync 

  TC->CTRLA.bit.RUNSTDBY = 1;  //allow to run in standby
  while (TC->STATUS.bit.SYNCBUSY == 1); // wait for sync 
  
  TC->CTRLA.reg |= TC_CTRLA_PRESCALER_DIV64;   // Set prescaler
  while (TC->STATUS.bit.SYNCBUSY == 1); // wait for sync 
  
//  TC->PER.reg = 0xFF;   // Set counter Top using the PER register but the 16/32 bit timer counts allway to max  
 // while (TC->STATUS.bit.SYNCBUSY == 1); // wait for sync 

  TC->CC[0].reg = 0xFFF;
  while (TC->STATUS.bit.SYNCBUSY == 1); // wait for sync 
  
  // Interrupts 
  TC->INTENSET.reg = 0;              // disable all interrupts
  TC->INTENSET.bit.OVF = 1;          // disable overflow
  TC->INTENSET.bit.MC0 = 0;          // enable compare match to CC0

  // Enable InterruptVector
  NVIC_EnableIRQ(TC3_IRQn);

  // Enable TC
  TC->CTRLA.reg |= TC_CTRLA_ENABLE;
  while (TC->STATUS.bit.SYNCBUSY == 1); // wait for sync 
}

void stopTimer(){
  // TcCount16* TC = (TcCount16*) TC3; // get timer struct
   NVIC_DisableIRQ(TC3_IRQn);
}

void TC3_Handler()
{
    TcCount16* TC = (TcCount16*) TC3; // get timer struct
  if (TC->INTFLAG.bit.OVF == 1) {  // A overflow caused the interrupt
      TC->INTFLAG.bit.OVF = 1;    // writing a one clears the flag ovf flag
      while(pollImu());
      irq_ovf_count++;
      rtc.standbyMode(); // go to sleep
  }
}
