loggerhead-instruments/iTag/(commit log)

2016-10-25 Initial commit of sensor test for iTag
2016-10-26 IMU read from timer interrupt
2017-01-17 All sensors writing to amx file. There will be timing jitter on sensors sampled once per second. Better solution is to use timer and to go to sleep.
    [iTag.ino]
2017-01-31 spec sheets
    [sensor_power_budget.xlsx]
2017-02-02 fix file format and sensor config IMU at 100 Hz
    [MPU9250.ino, MS5803.ino, PA7LD.ino, PRESENSE_O2.ino, iTag.ino]
2017-02-08 burn wire time set at startup through either number of minutes from start until burn or a given start time VHF triggered after burn wire triggered
    [iTag.ino, setupMenu.ino]
2017-02-14 1 minute files. LED on during menu stage
2017-02-14 LED off after first file
2017-02-14 fix IMU test so outputs to monitor
    [iTag.ino]
2017-02-14 LED on at start so can tell when magnet reset tag
    [iTag.ino]
2017-02-21 Drawing of iTag board
2017-03-23 hex output for O2 sensor to make sure phase and amplitude float calculated correctly
    [PRESENSE_O2.ino, iTag.ino, iTagSensorTest.ino]
2017-04-06 added 5bar pressure sensor #define use to specify which MS5803 pressure sensor
2017-04-06 IMU same as AMX
2017-04-19 Burst read IMU
    Burst read IMU and be aggressive about reading IMU buffer until empty.
    Needs to be relatively small buffer read (over 63 bytes doesn't work
    properly).
    [MPU9250.ino, MS5803.ino, iTag.ino]
2017-05-03 fix retry on NACK
    [mainwindow.cpp]
2017-05-03 read all sensors from interrupt. Fixes #6
    [MPU9250.ino, iTag.ino]
2017-05-03 flash LED when write IMU
2017-05-04 battery in Volts
2017-08-01 fix depth sensor scaling
    [MPU9250.ino, MS5803.ino, iTag.ino, iTagSensorTest.ino]
2017-11-03 initial salinity schematic
    [salinity.PrjPCB, salinity.SchDoc]
2017-11-03 temperature, RMS, and ADC
    [salinity.SchDoc]
2017-11-05 current source
    [salinity.SchDoc]
2017-11-06 Salinity pads
    [salinity.SchDoc]
2017-11-06 salinity PCB
    [salinity.PcbDoc, salinity.SchDoc]
2017-11-06 routing fix
    [salinity.PcbDoc, salinity.PrjPCB, salinity.SchDoc]
2018-02-22 update keller
    [Pick Place for salinity.csv, salinity.PrjPCB, salinity.SchDoc]
2018-04-11 low voltage, stop tag, VHF on, burn on
    [iTag.ino]
2018-04-11 if going to sleep, green LED off
2018-04-12 fix sleep
    LED Green logic backward
    sleep command added back
    [iTag.ino]
2018-04-12 low power after batt V low
2018-10-12 100 bar sensor
2019-05-12 Update iTag.ino to turn off burn during standby
    Turn on burn for burnDurMin, then deactivate before going into standby mode.
    Q1: L700, can mpu be turned off before burn wire, or will this interfere with for loop?
    Q2: L700 approximately, is IMU put into standby mode as well?
    [iTag.ino]
2019-05-13 Update iTag.ino
    Moved MPU power down up
2019-05-14 Update iTag.ino
    LowPower.powerDown only for AVR-based arduino; instead use RTCZero library to attach interrupt
2019-05-23 Go to sleep mode after burn is complete
    Added support to activate VHF and go to sleep mode after firing burn
    [iTag.ino]
2019-05-23 Pos bug in deactivation of VHF at depth
    Depth may be positive - will test and modify if needed
    [iTag.ino]
2019-05-23 Temp fix - deactivate VHF at depth
    Patch to deactivate VHF at depth; this needs to be fixed, but wanted to change without changing sensor values (so they stay consistent with calibration and other tag-outs).
    [iTag.ino]
2020-03-06 Azores_2019_version
    Known errors:
    -Adjust gyro sensitivity
    -Fix deactivating VHF at depth (both value of depth threshold and implementation in line 236/237)
    -Test sleep
    -Put in sleep when burning
    -Test sleep current draw
    -Add ms to file names
    [ISL29125.ino, iTag.ino]
